yonathan-star/splitbeacon/media/README.txt

Project-file concept visualization, PCB plot and CAD render; no physical device footage. Synthetic narration generated locally using the owner-authorized existing Pocket TTS voice reference. Voice reference and model weights are not included. Progress reel is a design walkthrough, not a claim about a five-hour recording point. No simulation or bench result is presented as real hardware performance.
