yonathan-star/splitbeacon/docs/SUBMISSION.md

# Submission fields

**Title:** SplitBeacon

**Week:** Week 4 — Displays

**Requested tier:** Tier 3 target

**Description:** SplitBeacon is a standalone lap and interval timer that makes pacing visible. A 64-pixel RGB display shows progress and split history while a 240x135 TFT shows precise timing, targets and session statistics. Three physical buttons record laps, pause the session and switch views. Target and brightness knobs, ambient dimming and piezo cues make it usable without a phone. The package includes an original controller PCB, protected power design, MicroPython firmware, a printable enclosure, assembly instructions and a vendor-priced BOM with actual cart screenshots.

**Why this tier:** The scope integrates electrical, mechanical and software design: a routed custom board, two display types, analog sensing, independent RGB data channels, a stateful timing interface, persistence and a serviceable case. Tier is a requested target, subject to review.

**Design files:** hardware/controller; firmware; mechanical; BOM.md; docs/carts.

**Journal:** journal/JOURNAL.md contains the five existing design sections, confirmed by the owner as 20 actual hours (3, 4, 5, 5 and 3). Individual session dates were not supplied.

**Media:** preview/splitbeacon.png is a concept visualization, preview/pcb.png is a plot from routed geometry, preview/enclosure.png is a CAD render. None is a photo of a finished device. Reels use project-file visuals with accurate render and narration labels.

**Authorship:** SplitBeacon is Yonathan’s project. Codex assisted with review and submission preparation; existing technical and AI-assistance credits remain in the source files.

**Submission status:** Prepared for live submission. Acceptance is not established until the website confirms it. Actual work records and program eligibility remain subject to review.
