yonathan-star/splitbeacon/docs/RESEARCH.md

# Browser research record

The authenticated Half Life website showed Week 4 as Displays Week, ending November 1, and Week 5 beginning November 2. Opened tier/submitting docs, display guide index, TFT and matrix guides. Tier 3 listed $100 and 20 actual hours. Read public project details rather than relying only on gallery cards.

Opened examples:
- pixelixx by Kosine: https://halflife.hackclub.com/projects/tprvb17bczr0nozbpg8gnhcu
- Modular Led Matrix by Stanley: https://halflife.hackclub.com/projects/u8rx23b637gqrgavl5v323de
- DAYFRAME by Erin: https://halflife.hackclub.com/projects/em2btzgkho5x1evdk2s31fc4

Their implementations are context only. SplitBeacon’s timing and lap-comparison design was created for this package. No source files were copied from those projects. Supplier availability caused the matrix, encoder and supply choices to change.

Real submissions require a public repository, useful README and images, priced BOM/cart evidence, firmware and actual personal work records. The live rules place limits on AI-assisted work. SplitBeacon is Yonathan’s project. Existing design notes and illustrative allocations do not establish actual personal work hours; eligibility must be supported by actual records.
