yonathan-star/splitbeacon/docs/carts/adafruit-cart.jpg

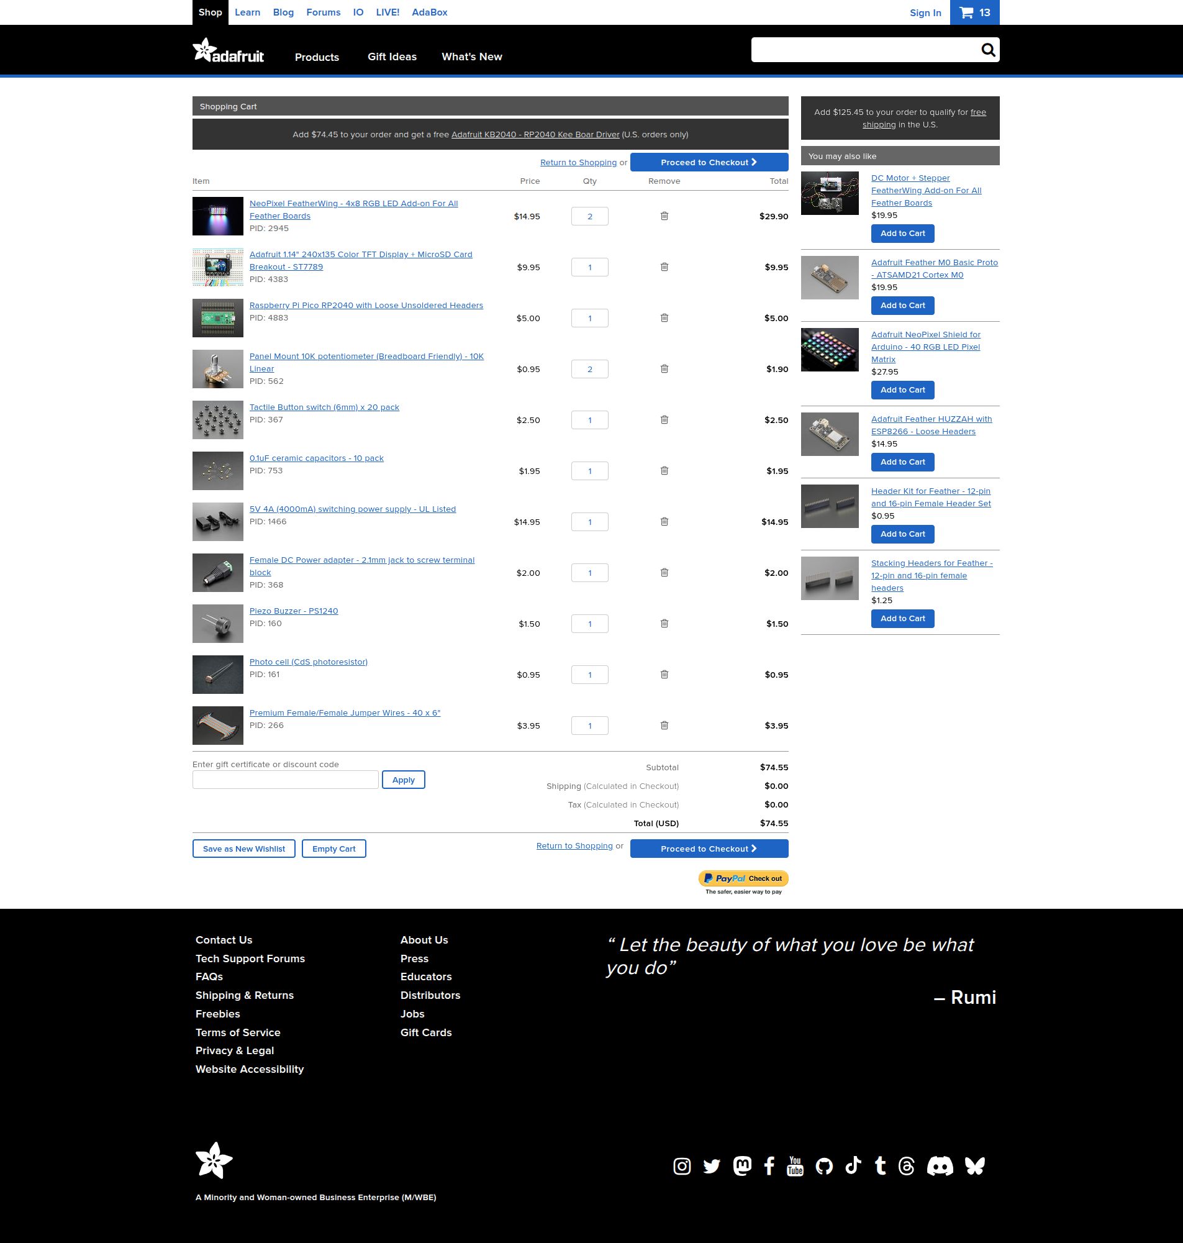
docs/carts/adafruit-cart.jpg
