yonathan-star/splitbeacon/docs/carts/digikey-cart.jpg

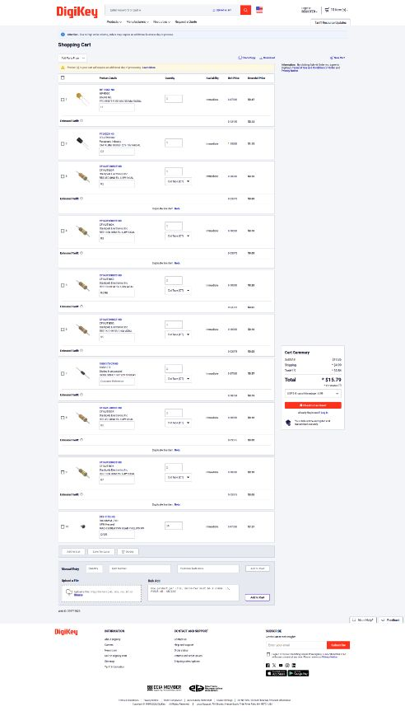
docs/carts/digikey-cart.jpg
