yonathan-star/splitbeacon/docs/carts/jlcpcb-quote.jpg

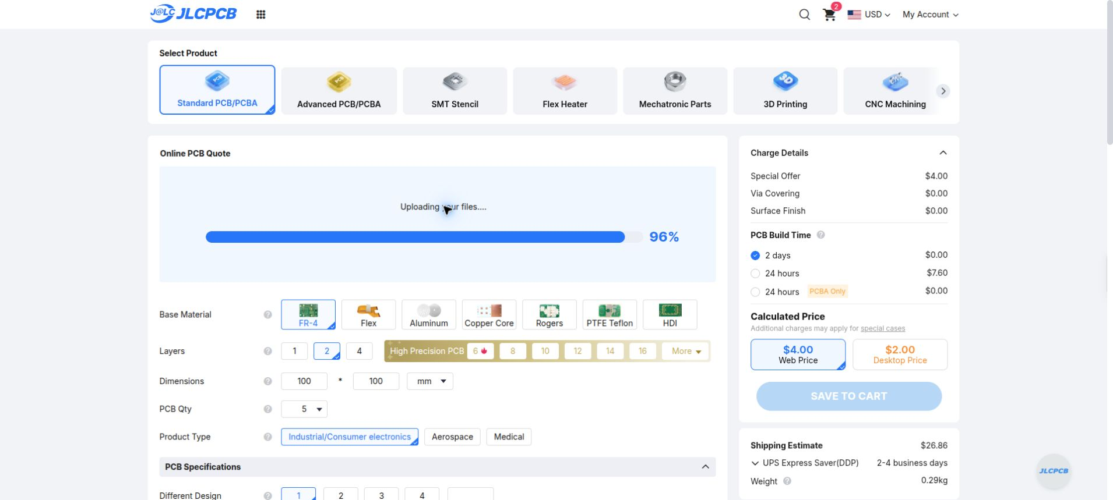
docs/carts/jlcpcb-quote.jpg
