yonathan-star/splitbeacon/docs/carts/polymaker-cart.jpg

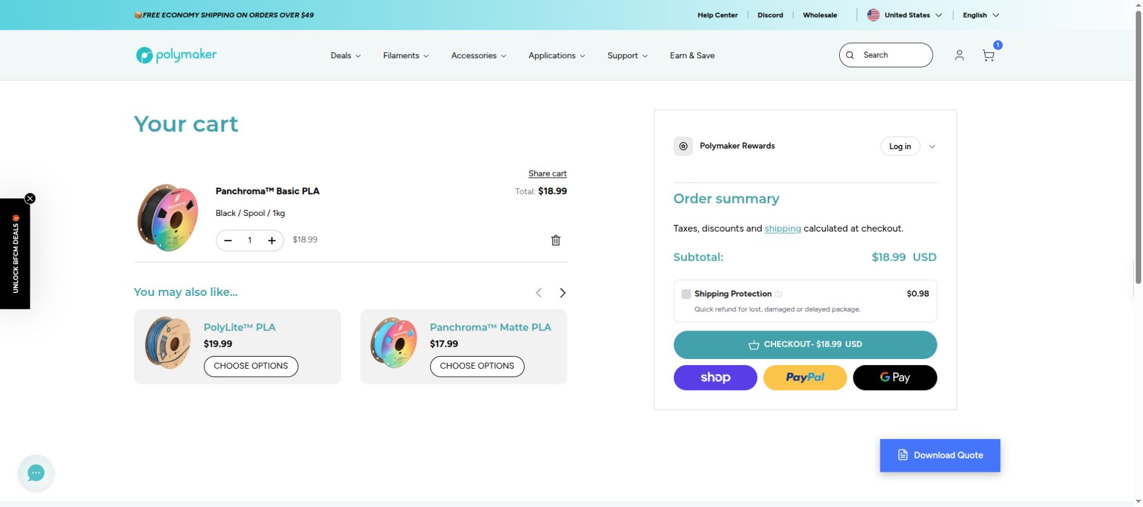
docs/carts/polymaker-cart.jpg
