yonathan-star/splitbeacon/preview/core-source.png

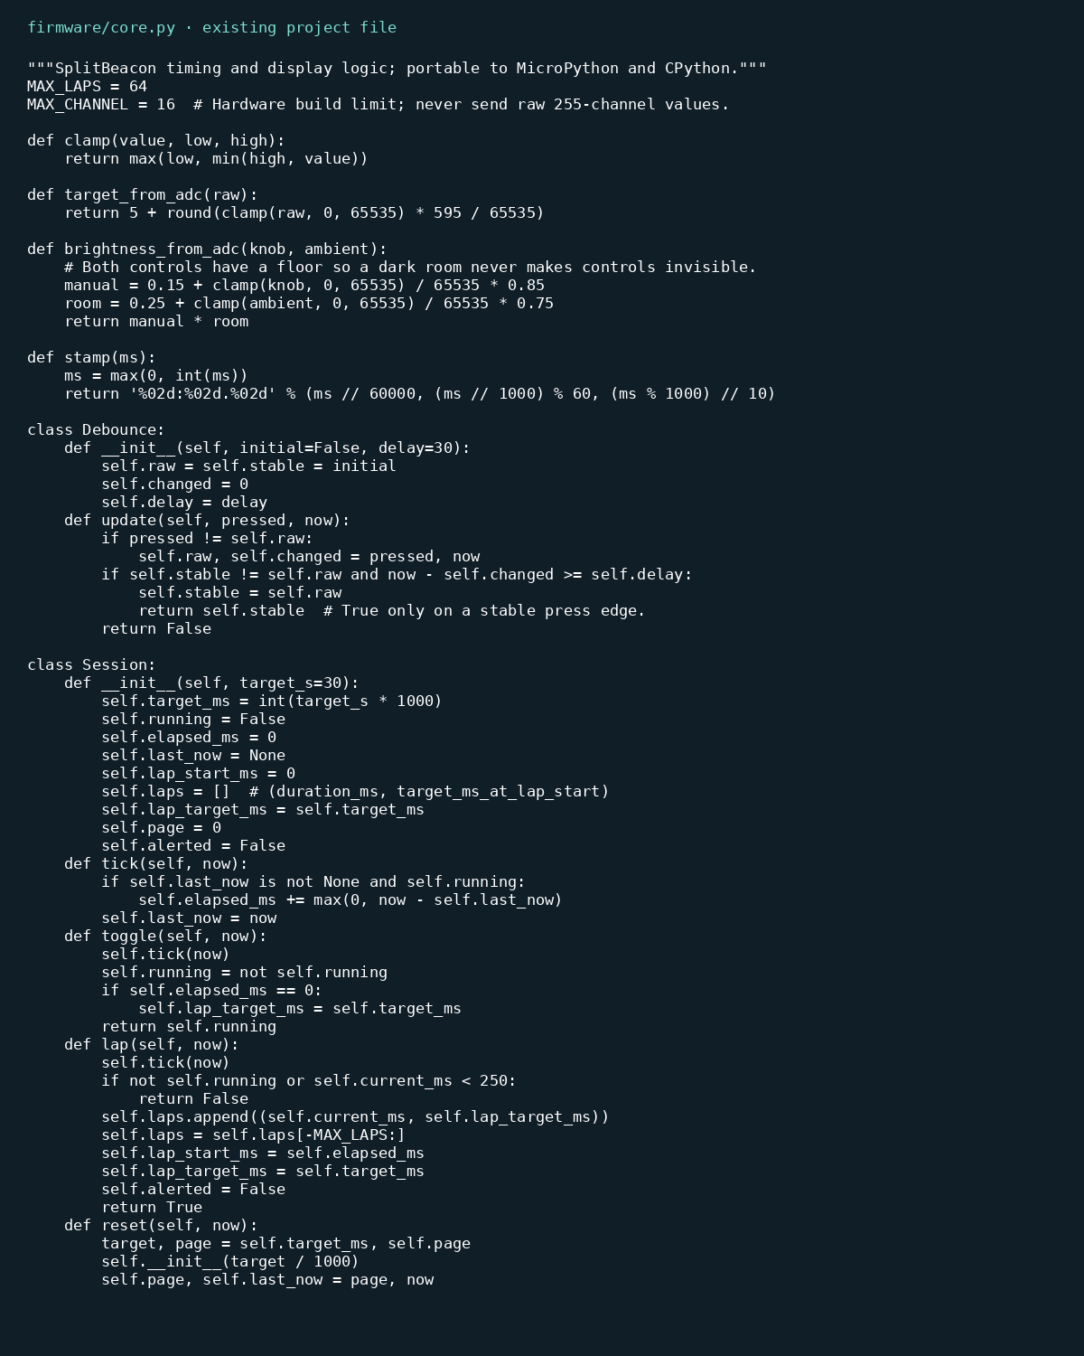
preview/core-source.png
