yonathan-star/splitbeacon/BOM.md

# SplitBeacon bill of materials

Verified in live supplier carts on November 1, 2026. All listed electronics were available for immediate purchase when checked. Prices can change. Purchase quantities include full packs and a full filament spool.

| Item | Vendor / SKU | Buy | Unit USD | Line USD |
|---|---|---:|---:|---:|
| [NeoPixel FeatherWing 4x8 RGB](https://www.adafruit.com/product/2945) | Adafruit 2945 | 2 | $14.950 | $29.90 |
| [1.14 inch ST7789 TFT 240x135](https://www.adafruit.com/product/4383) | Adafruit 4383 | 1 | $9.950 | $9.95 |
| [Pico RP2040 with loose headers](https://www.adafruit.com/product/4883) | Adafruit 4883 | 1 | $5.000 | $5.00 |
| [10k linear panel potentiometer](https://www.adafruit.com/product/562) | Adafruit 562 | 2 | $0.950 | $1.90 |
| [6mm tactile button 20 pack](https://www.adafruit.com/product/367) | Adafruit 367 | 1 | $2.500 | $2.50 |
| [100nF ceramic capacitor 10 pack](https://www.adafruit.com/product/753) | Adafruit 753 | 1 | $1.950 | $1.95 |
| [5V 4A regulated power supply](https://www.adafruit.com/product/1466) | Adafruit 1466 | 1 | $14.950 | $14.95 |
| [2.1mm female jack to screw terminal](https://www.adafruit.com/product/368) | Adafruit 368 | 1 | $2.000 | $2.00 |
| [PS1240 passive piezo](https://www.adafruit.com/product/160) | Adafruit 160 | 1 | $1.500 | $1.50 |
| [CdS photocell](https://www.adafruit.com/product/161) | Adafruit 161 | 1 | $0.950 | $0.95 |
| [40 female/female 150mm jumper wires](https://www.adafruit.com/product/266) | Adafruit 266 | 1 | $3.950 | $3.95 |
| [MF-R050 500mA radial PTC](https://www.digikey.com/en/products/detail/bourns-inc/MF-R050/259965) | DigiKey MF-R050-ND | 1 | $0.470 | $0.47 |
| [EEU-FR1A102 1000uF 10V](https://www.digikey.com/en/products/detail/panasonic-industry/EEU-FR1A102/9921022) | DigiKey P124221-ND | 1 | $1.150 | $1.15 |
| [330 ohm axial 1/4W 5%](https://www.digikey.com/en/products/detail/stackpole-electronics-inc/CF14JT330R/1741399) | DigiKey CF14JT330RCT-ND | 2 | $0.100 | $0.20 |
| [100k axial 1/4W 5%](https://www.digikey.com/en/products?keywords=CF14JT100K) | DigiKey CF14JT100KCT-ND | 2 | $0.100 | $0.20 |
| [10k axial 1/4W 5%](https://www.digikey.com/en/products?keywords=CF14JT10K0) | DigiKey CF14JT10K0CT-ND | 2 | $0.100 | $0.20 |
| [1k axial 1/4W 5%](https://www.digikey.com/en/products?keywords=CF14JT1K00) | DigiKey CF14JT1K00CT-ND | 1 | $0.100 | $0.10 |
| [1N5817-T Schottky diode DO41](https://www.digikey.com/en/products/detail/diodes-incorporated/1N5817-T/22052) | DigiKey 1N5817DICT-ND | 1 | $0.370 | $0.37 |
| [M3x6 Phillips pan-head screw](https://www.digikey.com/en/products/detail/apm-hexseal/RM3X6MM-2701/612968) | DigiKey 335-1156-ND | 16 | $0.473 | $7.57 |
| [Black PLA 1.75mm 1kg spool](https://shop.polymaker.com/products/panchroma-pla?variant=44863271731257) | Polymaker CA19006 | 1 | $18.990 | $18.99 |

**Cart reconciliation:** Adafruit $74.55 + DigiKey $10.26 + Polymaker $18.99 = **$103.80 in purchased parts/material**. DigiKey shows estimated shipping $4.99 and tariff $0.54, total $15.79. Adafruit and Polymaker shipping/tax are calculated at checkout and are not zero-cost promises.

**PCB fabrication is additional.** Live JLCPCB analysis accepted a 100x100mm, two-layer board. The saved screenshot is a dimension-based quote, not a saved PCB cart. The earlier upload was detected correctly; after sign-in navigation the upload was not retained. Initial web quote was $4 for five boards, with the displayed express shipping estimate $26.86. The $2 advertised price applies to its desktop app and is not used as the web quote. No PCB purchase was made.

Against a $100 grant, full-cart parts alone exceed funding by $3.80. With the initial PCB quote and known DigiKey charges, the known amount is $113.33 before other shipping/tax and PCB shipping. Reusing an existing filament spool lowers new parts purchases by $18.99, but ownership of a spool is not assumed.

Headers: Pico headers are included. Use only the three required pads per FeatherWing, cutting individual pins from the supplied header strips. The remaining included header pins supply controller J1-J8. TFT header is included with its breakout. No sockets are required.

Consumables/tools: solder, insulation for soldered wire joints, a soldering iron, multimeter, screwdriver, printer access and a USB data cable are workshop requirements. Their ownership/cost is not verified and they are not hidden as purchased BOM lines.

Actual cart evidence: [Adafruit](docs/carts/adafruit-cart.jpg), [DigiKey](docs/carts/digikey-cart.jpg), [Polymaker](docs/carts/polymaker-cart.jpg).
