yonathan-star/splitbeacon/preview/bom.png

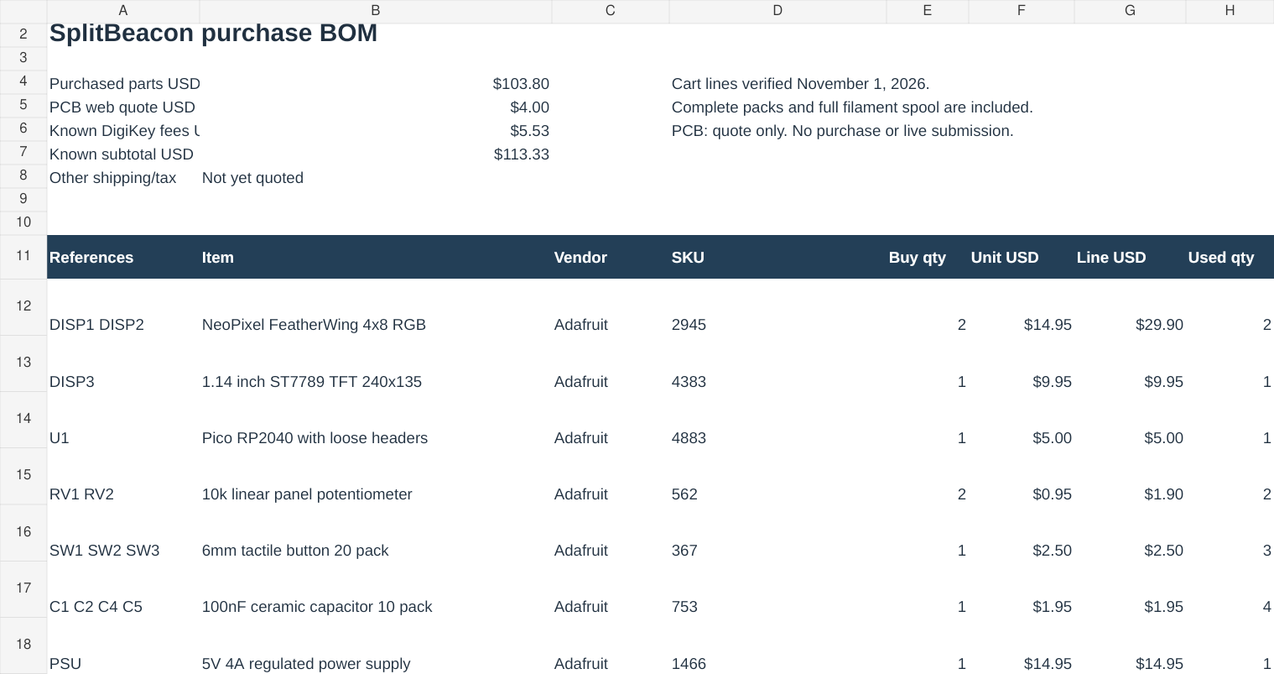
preview/bom.png
