yonathan-star/splitbeacon/mechanical/plunger.stl

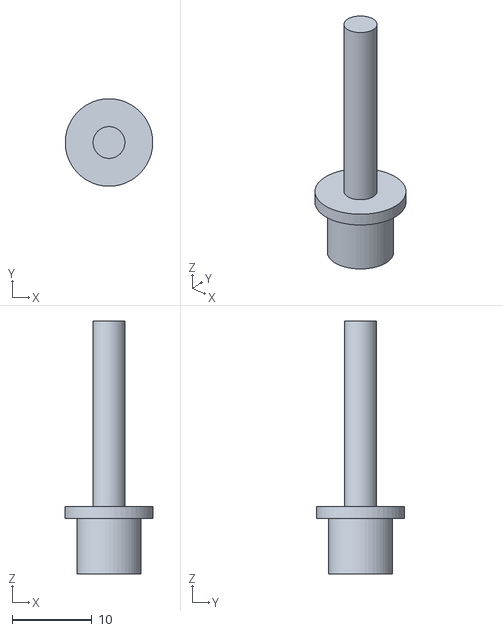
[picture p10: CAD file, 2026-11-02]
mechanical/plunger.stl
11.0 x 11.0 x 31.8
