yonathan-star/splitbeacon/mechanical/lid.stl

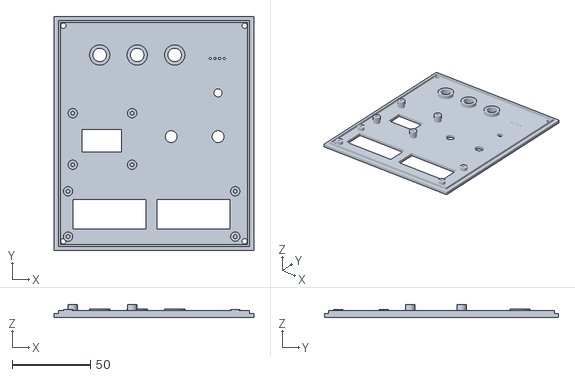
[picture p11: CAD file, 2026-11-02]
mechanical/lid.stl
128.0 x 150.0 x 8.20
