yonathan-star/splitbeacon/mechanical/matrix_retainer.stl

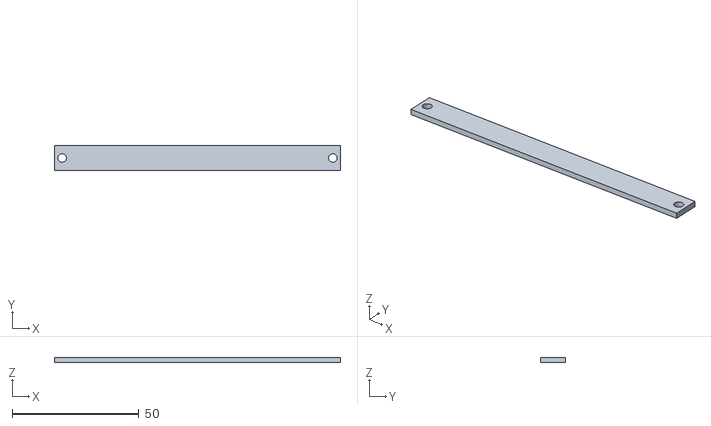
[picture p12: CAD file, 2026-11-02]
mechanical/matrix_retainer.stl
113.0 x 10.0 x 2.00
