yonathan-star/splitbeacon/mechanical/retainer.stl

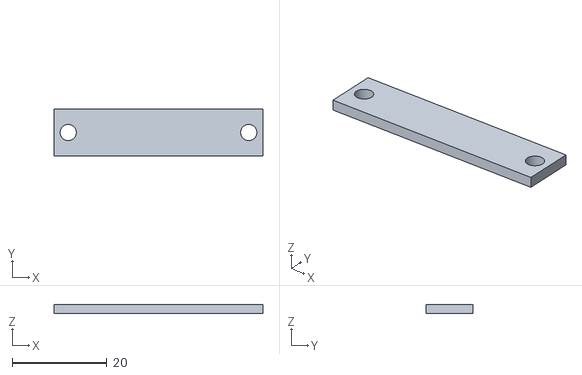
[picture p13: CAD file, 2026-11-02]
mechanical/retainer.stl
44.0 x 10.0 x 2.00
