yonathan-star/splitbeacon/mechanical/coupon.stl

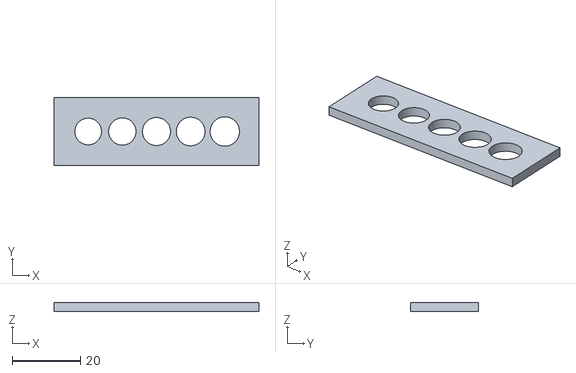
[picture p14: CAD file, 2026-11-02]
mechanical/coupon.stl
60.0 x 20.0 x 2.50
