yonathan-star/splitbeacon/mechanical/base.stl

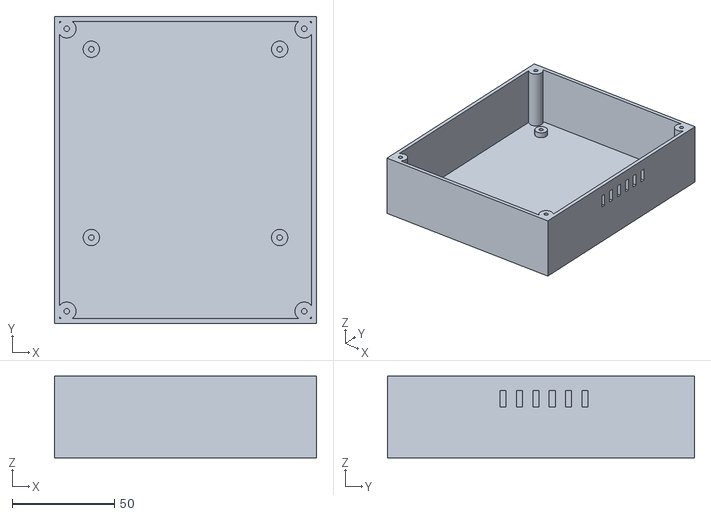
[picture p15: CAD file, 2026-11-02]
mechanical/base.stl
128.0 x 150.0 x 40.0
