yonathan-star/splitbeacon/preview/WIRING-source.png

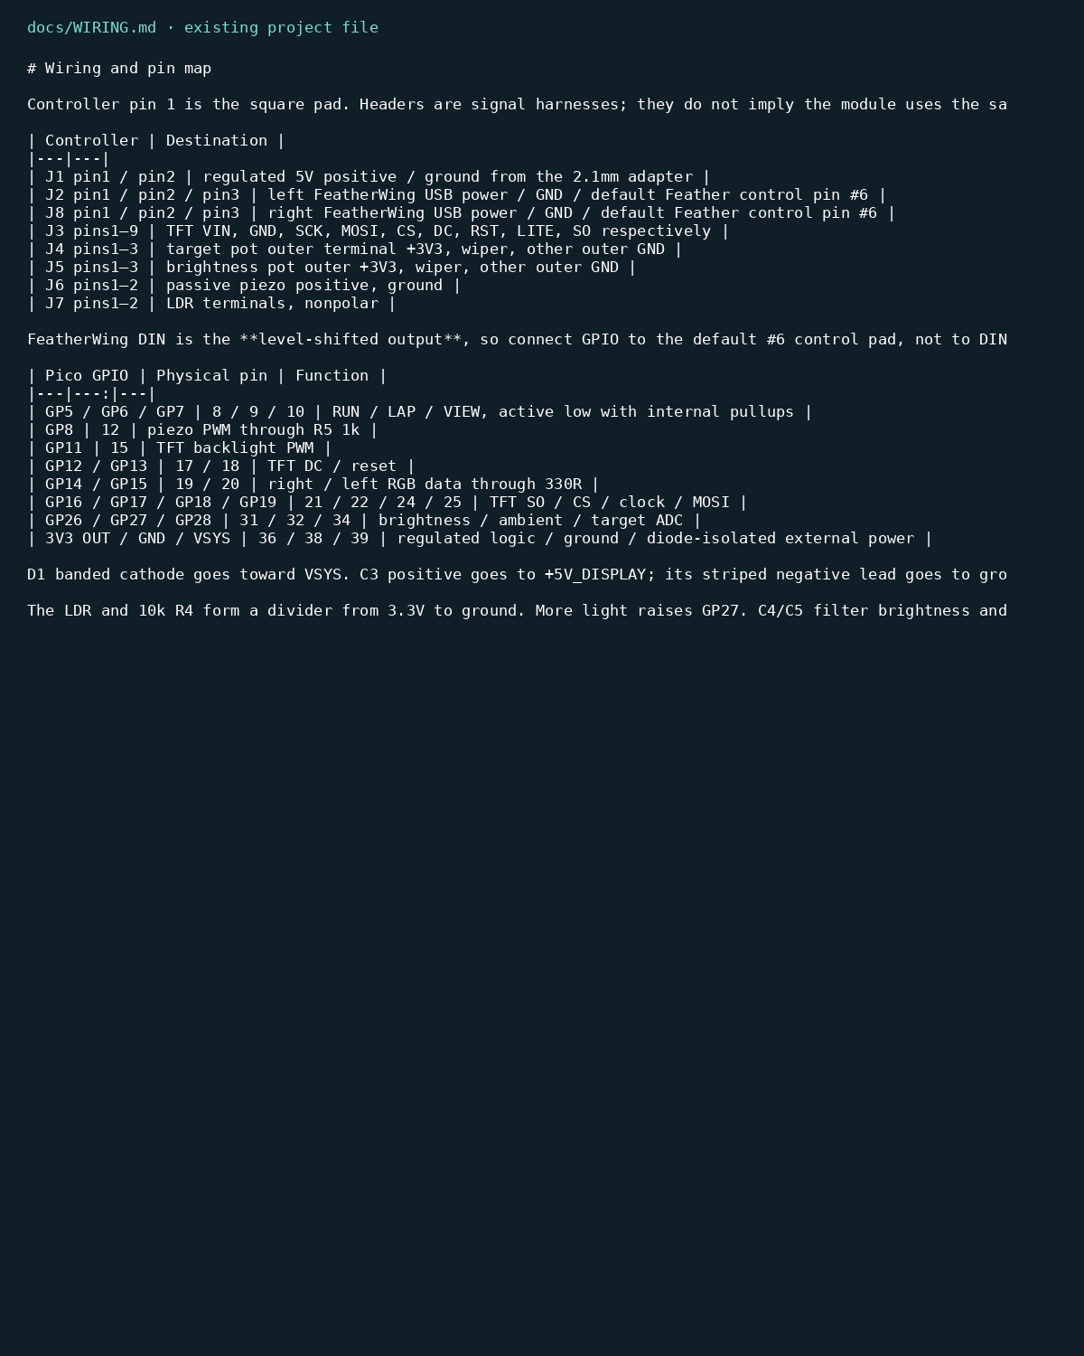
preview/WIRING-source.png
