yonathan-star/splitbeacon/verification/netlist-check.txt

PASS: 88 connected logical pins match schematic export and routed PCB.
Explicit NC pins excluded; mounting holes are mechanical only.
This is a connectivity consistency check, not electrical ERC.
