yonathan-star/splitbeacon/preview/firmware-tests-source.png

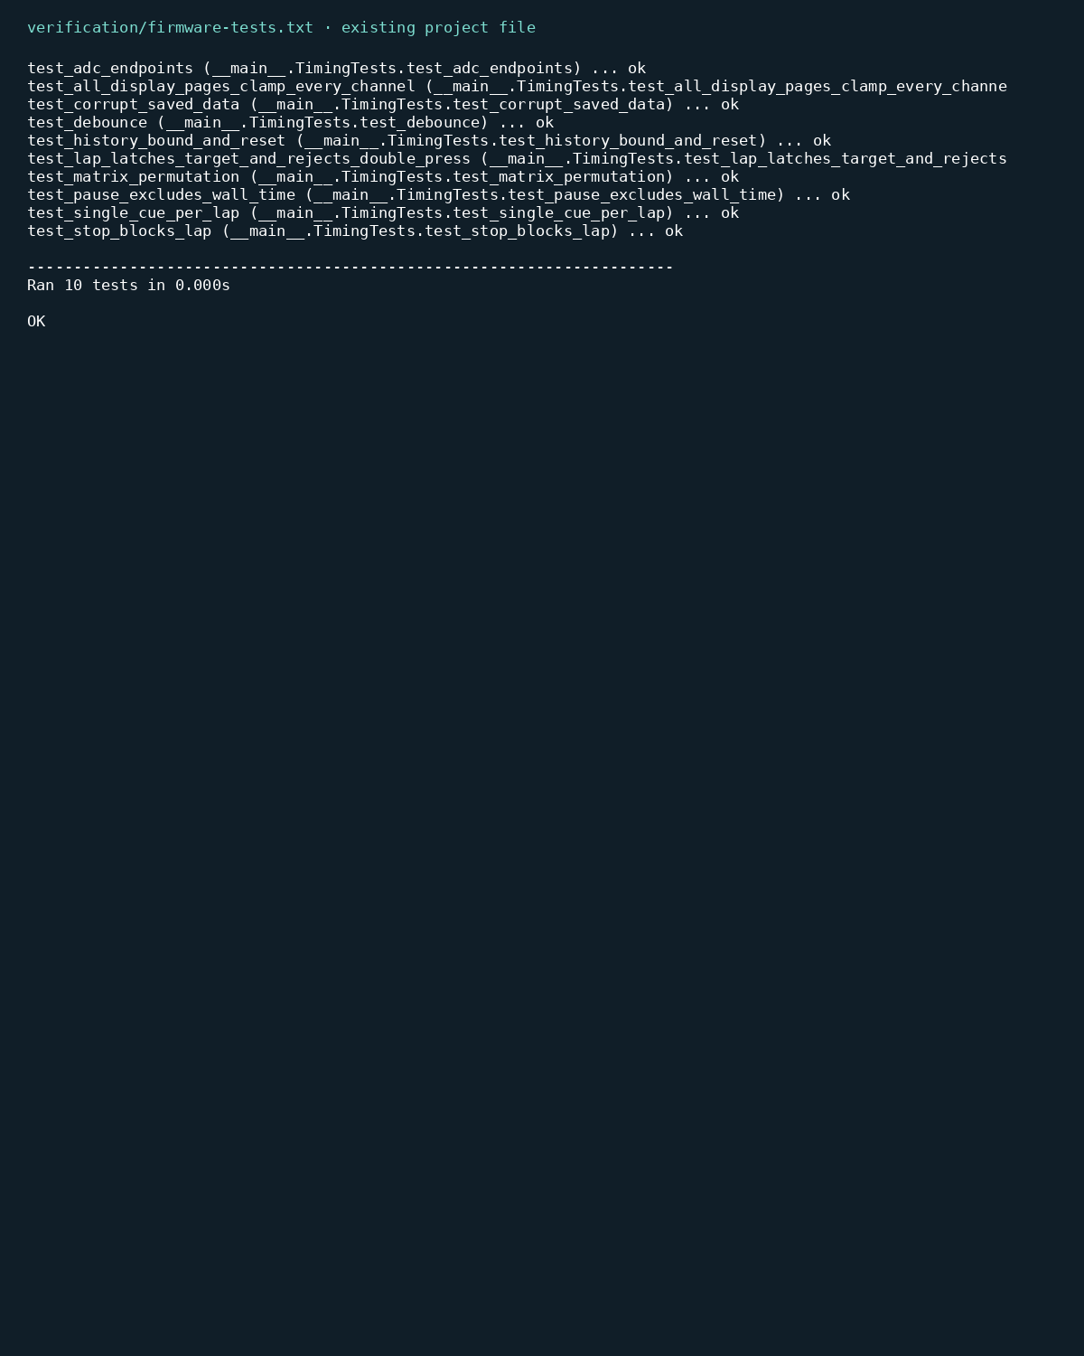
preview/firmware-tests-source.png
