yonathan-star/splitbeacon/hardware/controller/controller.kicad_pcb

## KiCad design hardware/controller/controller.kicad_pcb (2026-11-02)

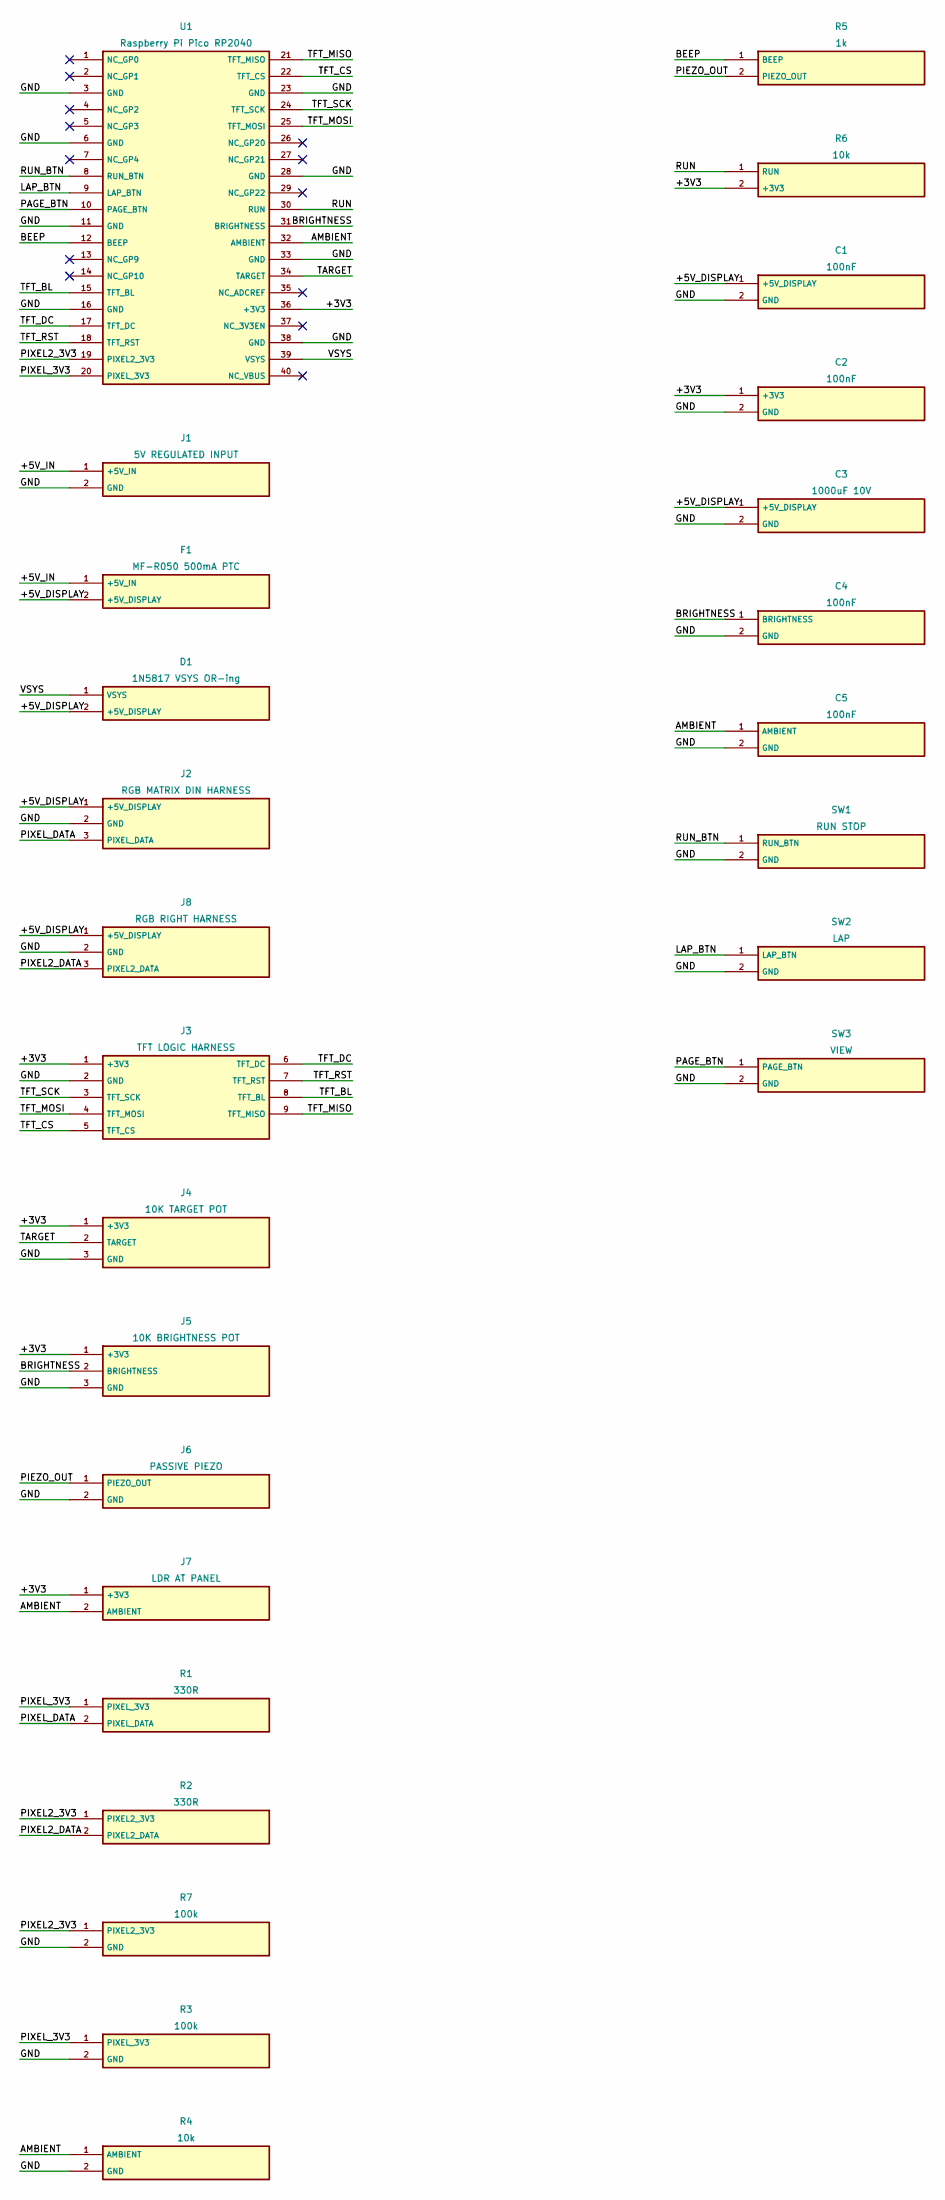
[picture p18: schematic controller.kicad_sch, SplitBeacon - controller]

Parts:
C1, C2, C4, C5: 100nF; C_Disc_D3.0mm_W1.6mm_P2.50mm
C3: 1000uF 10V; CP_Radial_D10.0mm_P5.00mm
D1: 1N5817 VSYS OR-ing; D_DO-41_SOD81_P10.16mm_Horizontal
F1: MF-R050 500mA PTC; PTC_5mm
J1: 5V REGULATED INPUT; PinHeader_1x02_P2.54mm_Vertical
J2: RGB MATRIX DIN HARNESS; PinHeader_1x03_P2.54mm_Vertical
J3: TFT LOGIC HARNESS; PinHeader_1x09_P2.54mm_Vertical
J4: 10K TARGET POT; PinHeader_1x03_P2.54mm_Vertical
J5: 10K BRIGHTNESS POT; PinHeader_1x03_P2.54mm_Vertical
J6: PASSIVE PIEZO; PinHeader_1x02_P2.54mm_Vertical
J7: LDR AT PANEL; PinHeader_1x02_P2.54mm_Vertical
J8: RGB RIGHT HARNESS; PinHeader_1x03_P2.54mm_Vertical
R1, R2: 330R; R_Axial_DIN0207_L6.3mm_D2.5mm_P10.16mm_Horizontal
R3, R7: 100k; R_Axial_DIN0207_L6.3mm_D2.5mm_P10.16mm_Horizontal
R4, R6: 10k; R_Axial_DIN0207_L6.3mm_D2.5mm_P10.16mm_Horizontal
R5: 1k; R_Axial_DIN0207_L6.3mm_D2.5mm_P10.16mm_Horizontal
SW1: RUN STOP; Button_6mm
SW2: LAP; Button_6mm
SW3: VIEW; Button_6mm
U1: Raspberry Pi Pico RP2040; Pico_Socket

Connections:
+3V3: C2.1 (+3V3), J3.1 (+3V3), J4.1 (+3V3), J5.1 (+3V3), J7.1 (+3V3), R6.2 (+3V3), U1.36 (+3V3)
+5V_DISPLAY: C1.1 (+5V_DISPLAY), C3.1 (+5V_DISPLAY), D1.2 (+5V_DISPLAY), F1.2 (+5V_DISPLAY), J2.1 (+5V_DISPLAY), J8.1 (+5V_DISPLAY)
+5V_IN: F1.1 (+5V_IN), J1.1 (+5V_IN)
AMBIENT: C5.1 (AMBIENT), J7.2 (AMBIENT), R4.1 (AMBIENT), U1.32 (AMBIENT)
BEEP: R5.1 (BEEP), U1.12 (BEEP)
BRIGHTNESS: C4.1 (BRIGHTNESS), J5.2 (BRIGHTNESS), U1.31 (BRIGHTNESS)
GND: C1.2 (GND), C2.2 (GND), C3.2 (GND), C4.2 (GND), C5.2 (GND), J1.2 (GND), J2.2 (GND), J3.2 (GND), J4.3 (GND), J5.3 (GND), J6.2 (GND), J8.2 (GND), R3.2 (GND), R4.2 (GND), R7.2 (GND), SW1.2 (GND), SW2.2 (GND), SW3.2 (GND), U1.3 (GND), U1.6 (GND), U1.11 (GND), U1.16 (GND), U1.23 (GND), U1.28 (GND), U1.33 (GND), U1.38 (GND)
LAP_BTN: SW2.1 (LAP_BTN), U1.9 (LAP_BTN)
PAGE_BTN: SW3.1 (PAGE_BTN), U1.10 (PAGE_BTN)
PIEZO_OUT: J6.1 (PIEZO_OUT), R5.2 (PIEZO_OUT)
PIXEL2_3V3: R2.1 (PIXEL2_3V3), R7.1 (PIXEL2_3V3), U1.19 (PIXEL2_3V3)
PIXEL2_DATA: J8.3 (PIXEL2_DATA), R2.2 (PIXEL2_DATA)
PIXEL_3V3: R1.1 (PIXEL_3V3), R3.1 (PIXEL_3V3), U1.20 (PIXEL_3V3)
PIXEL_DATA: J2.3 (PIXEL_DATA), R1.2 (PIXEL_DATA)
RUN: R6.1 (RUN), U1.30 (RUN)
RUN_BTN: SW1.1 (RUN_BTN), U1.8 (RUN_BTN)
TARGET: J4.2 (TARGET), U1.34 (TARGET)
TFT_BL: J3.8 (TFT_BL), U1.15 (TFT_BL)
TFT_CS: J3.5 (TFT_CS), U1.22 (TFT_CS)
TFT_DC: J3.6 (TFT_DC), U1.17 (TFT_DC)
TFT_MISO: J3.9 (TFT_MISO), U1.21 (TFT_MISO)
TFT_MOSI: J3.4 (TFT_MOSI), U1.25 (TFT_MOSI)
TFT_RST: J3.7 (TFT_RST), U1.18 (TFT_RST)
TFT_SCK: J3.3 (TFT_SCK), U1.24 (TFT_SCK)
VSYS: D1.1 (VSYS), U1.39 (VSYS)

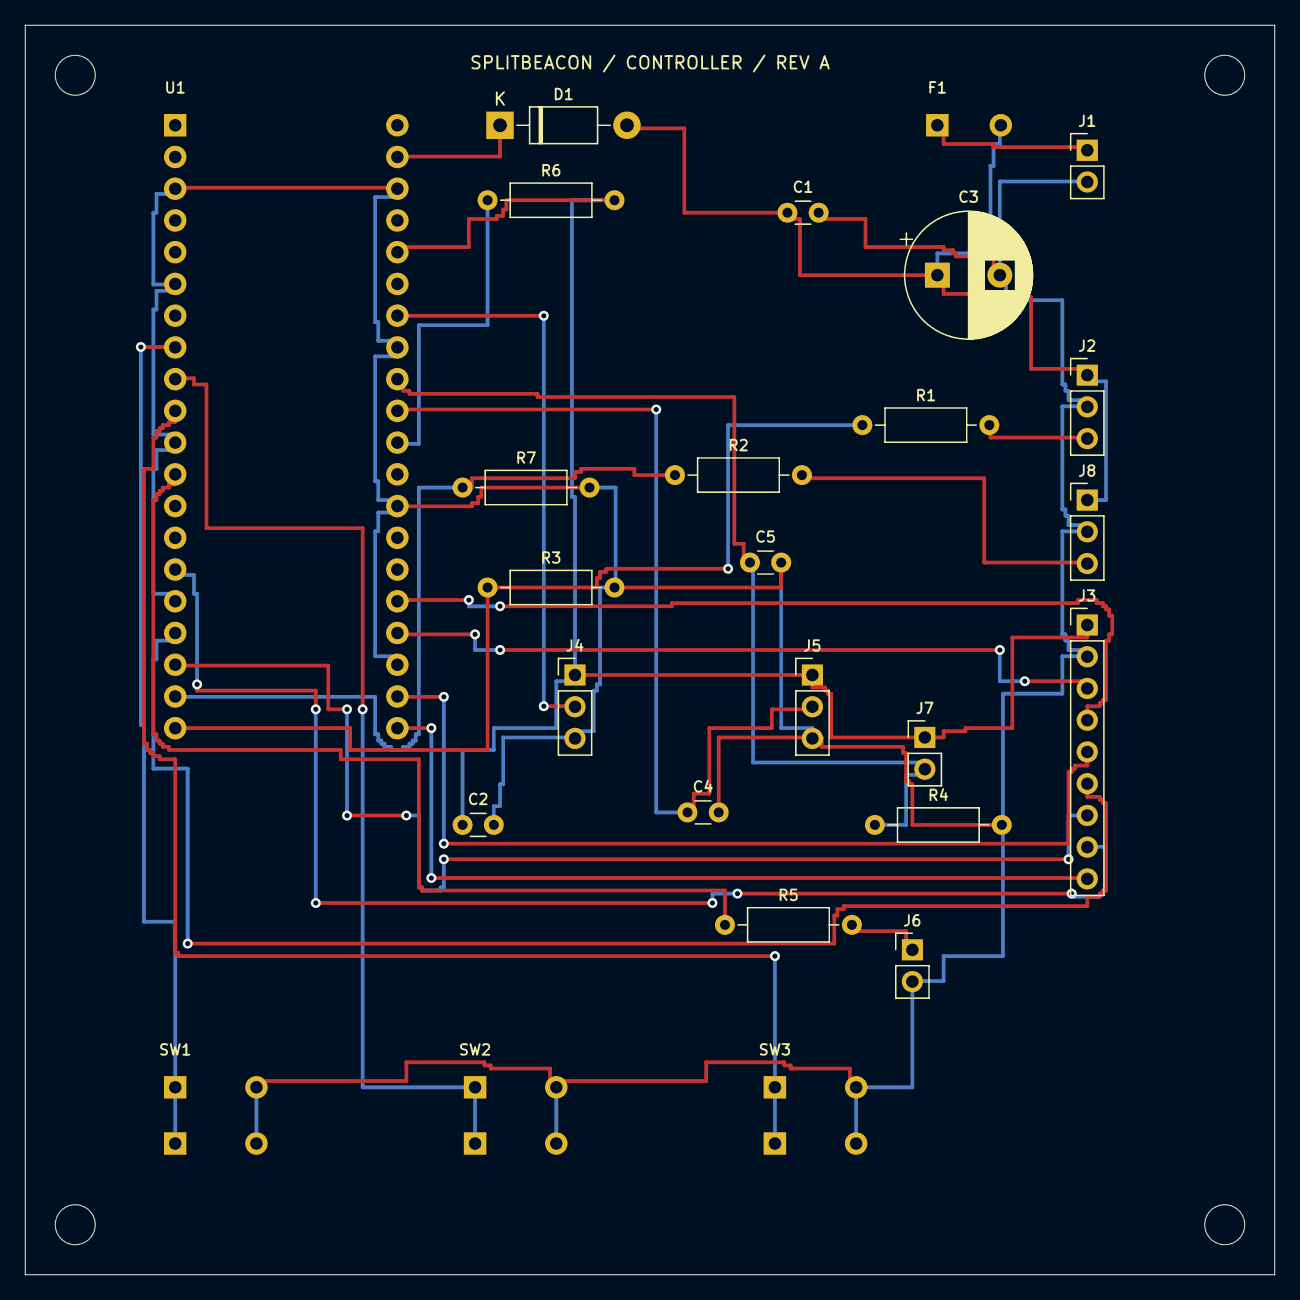
[picture p19: board controller.kicad_pcb from above]

Board: 2 copper layers, 100.0 x 100.0 mm, 30 parts (0 on the bottom side), 25 nets.

Other parts of the board:
H44, H496, H964, H9696: MountingHole_3.2mm_M3
