yonathan-star/splitbeacon/(commit log)

2026-11-02 Prepare SplitBeacon design submission with corrected attribution and labeled media
    [BOM.csv, SplitBeacon-BOM.xlsx, base.stl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]
2026-11-02 Use import-compatible BOM column headings
    [BOM.csv]
